capstone411/SHAF/README.md

# SHAF - Safe, Healthy, Active, and Flexible
All documents, code, presentations related to the SHAF team for capstone project at PSU (2015-2016)
