capstone411/SHAF/Capstone/bluetooth/Bluetooth_Specs.pptx

## Bluetooth Specs.

## Services

- Only 1 service is needed in the Bluetooth shield on the Arduino Board
- This service contains 3 characteristics
- UUID: 0x180D

## Characteristics

- 4 characteristics
  - Calibration flag
  - Rep Count
  - Fatigue Flag
  - Start/Stop Flag
- UUIDs
  - Calibration flag: 0x2a36
  - Rep Count: 0x2a37
  - Fatigue Flag: 0x2a38
  - Start/Stop Flag: 0x2a39
