capstone411/SHAF/Capstone/Presentations/semiFinalCornellCup.pptx

## SHAF (Safe, Healthy, Active and Flexible)

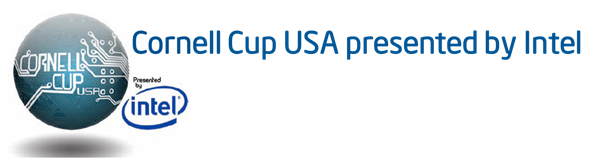
[picture p17: figure]

## Team Information

Students:

Ahmed Abdulkareem - Undergraduate Computer Engineer

Hai Dang Hoang - Undergraduate Computer Engineer

Todd Harlow - Undergraduate Computer Engineer

Thanh Tien Truong - Undergraduate Computer Engineer

Supervisor:

Mark Faust - Assistant Professor

## Topics

What is the challenge we want to focus on?

What is our solution to that challenge ?

How can we implement our solution ?

What work have we done so far ?

What are our next steps ?

## Challenge and Solution

45 million American adults have gym memberships in recent year

35 percent increase in workout-related injuries in recent years due to improper technique or inappropriate exercises

Many people don’t maximize the benefits of the exercises they perform because they don’t train the muscle intensely enough.

The ideal solution:
- Inexpensive and easy-to-use device
- Effective at providing correct methods for many exercises
- Accurate at alerting users to when they should stop

## Objective

To design and prototype a wearable device that can effectively support a user’s workout by allowing them to select their targeted muscle group and a corresponding exercise. Our device will provide users examples of the chosen exercise, count correct repetitions, and accurately alert them when they should stop the exercise. The device should be safe, easy to use, and portable.

## Current Existing Solutions and Our Solution

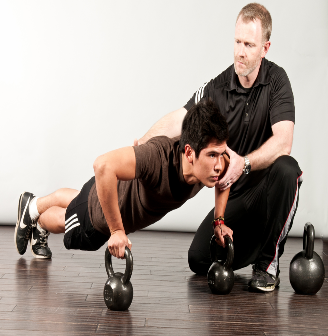
[picture p18: figure]
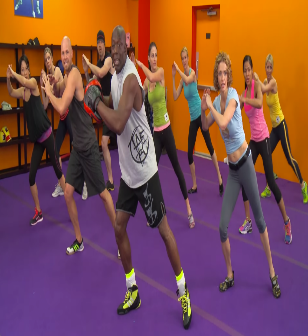
[picture p19: figure]

Workout Videos
3
3
2
5
5
18

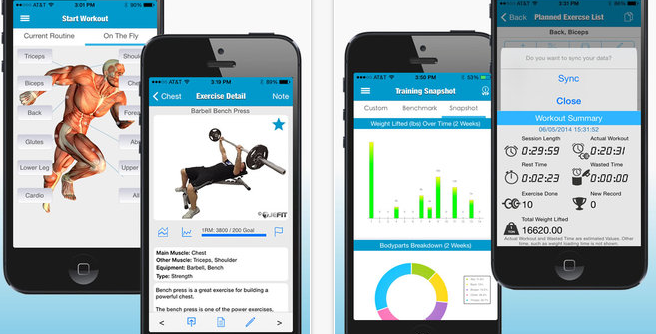
[picture p20: figure]

Videos Recording
5
3
2
4
3
17

| Personal Trainers
Cost | 1
Effectiveness | 5
Flexibility | 4
Ease of use | 5
Support all types of exercise | 5
Total | 20

Our Solution
4
4
5
5
3
21

A device that can:
  - Measure the intensity of muscle activity
  - Record the results
  - Correct your form
  - Detect muscle fatigue
  - Be used by anyone who wishes to improve their workouts and avoid injury

## Main Use Cases

Measure the intensity of a given muscle’s activity

Count the number of reps

Detect the muscle fatigue index

Provide video examples

Are my biceps “pumped”?

How many correct reps have I done so far?

When should I stop?

How can I perform an exercise correctly?

## Our Technical Solution

We use surface electromyography (sEMG) sensors to capture the voltage difference created by a contracting muscle

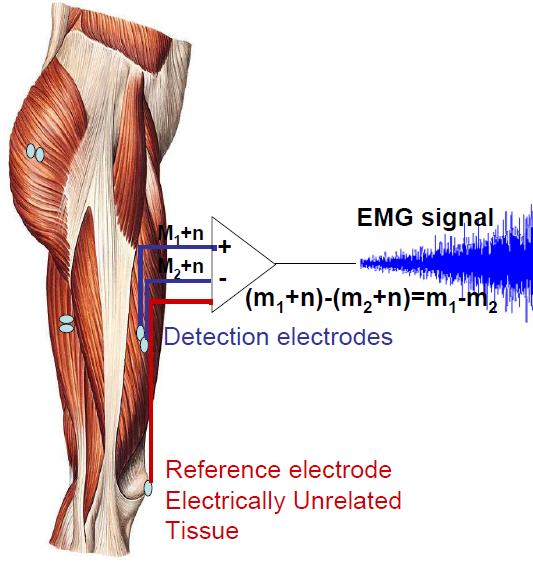
[picture p21: figure]

sEMG signals

We employ both simple and complex digital signal processing to extract key features

Time-domain processing
Frequency-domain processing

Is the muscle active ?
When is the muscle contracted / relaxed ?
How intense is the muscle activity?
Is the muscle fatigued?

## Our Physical Solution

A wearable sleeve working in conjunction with an Intel powered smart device

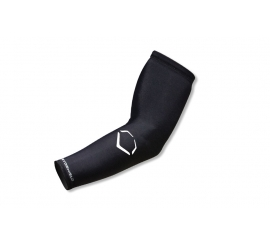
[picture p22: figure]
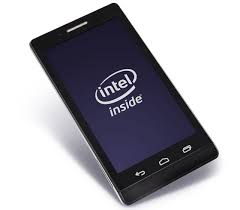
[picture p23: figure]
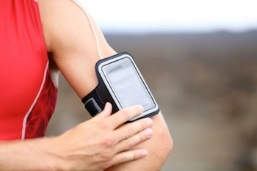
[picture p24: figure]

A wearable sleeve will measure sEMG signals and transmit data to a smart device

The smart device will let users choose the target muscle, the specific exercise for that muscle, and provide feedback

## Our Solution Summary

- sEMG sensors to record muscle data
  - Wearable garment containing custom-made sEMG electrodes and supporting circuitry.
  - Communicates via Bluetooth to smart device

- Intel Atom powered smart device to process data
  - Time-domain processing for muscle activation
  - Frequency-domain processing for muscle fatigue

- Device will also provide user interface
  - Audio and visual cues to keep user informed

## Flowchart for Our Solution

Time-domain analysis
Frequency-domain analysis

Intel Atom

Wearable sleeve with sEMG sensors

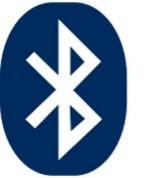
[picture p25: figure]

Is the muscle active?
When is the muscle contracted/relaxed?
How intense is the muscle activity?
Is the muscle fatigued?

User Interface

## Risks

What if the Intel Atom cannot handle all the signal and user interface processing?

What if our custom-made electrodes fail to provide an adequate signal?

Shift some or all signal processing
to an FPGA

We will use the off the shelf electrodes

## Our Current Achievements

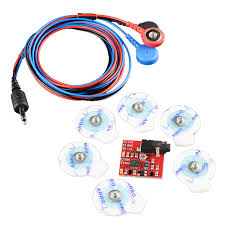
[picture p26: figure]

Muscle Sensor V3 (sEMG sensor)

Successfully detected when muscle is contracted or relaxed and can count repetitions

Making progress on detecting muscle fatigue

Completed a concept for user interface

## Muscle is contracted/relaxed

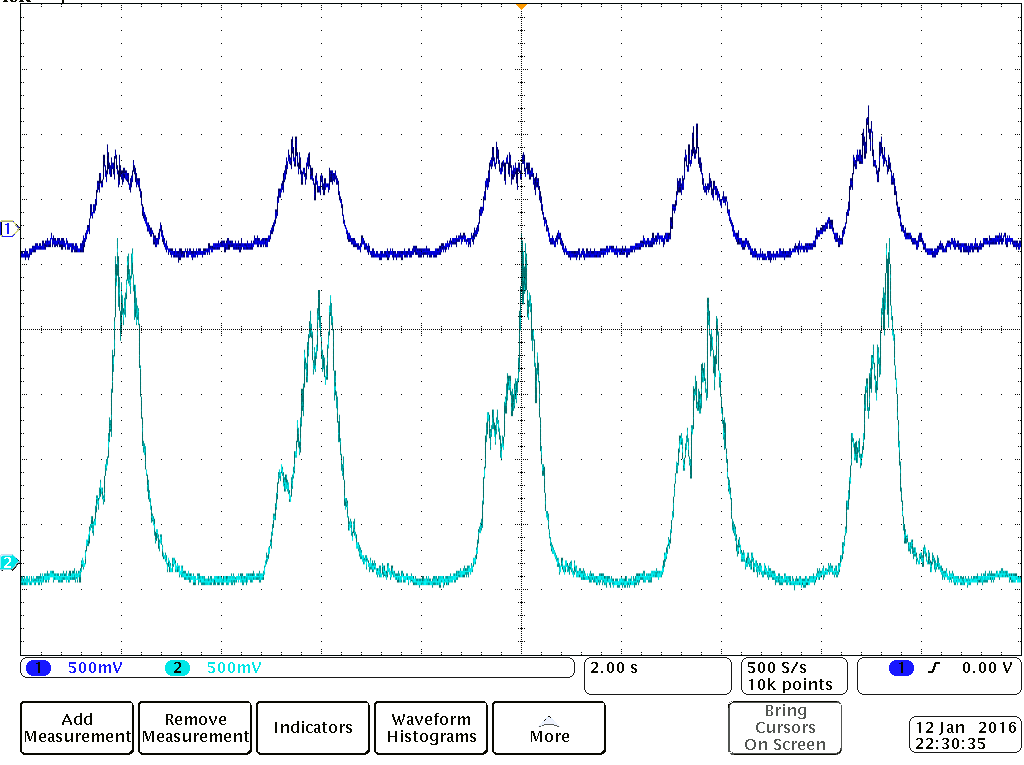
[picture p27: figure]

Doing multiple curls (sEMG signal for bicep and tricep)

tricep

bicep

## Muscle is contracted/relaxed

sEMG signal from the sensor

ADC

Not in range

Within acceptable range of upper bound threshold?

in range (contracted)

Within acceptable range of lower bound threshold?

in range (relaxed)

Increment rep

ADC

Not in range

## Demo Video

https://www.youtube.com/watch?v=X1IopbZivjs&fea

## Detecting Muscle Fatigue

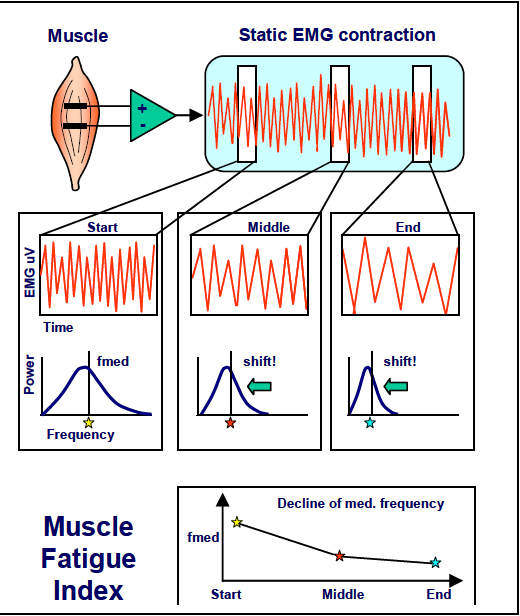
[picture p28: figure]

Konrad, P. (2006). The ABC of EMG – A Practical Introduction to Kinesiological Electromyography. Noraxon U.S.A. Inc

Key idea:
Mean or median frequency will decrease when muscle is fatigued

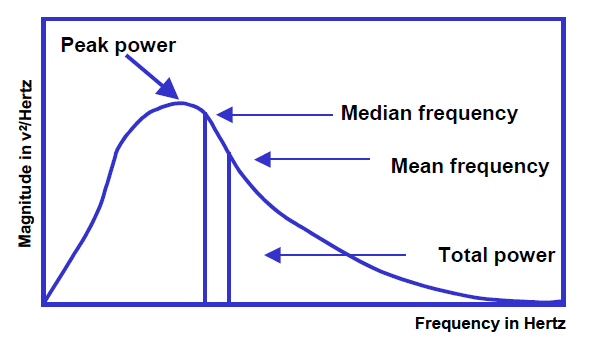
[picture p29: figure]

## Detecting Muscle Fatigue

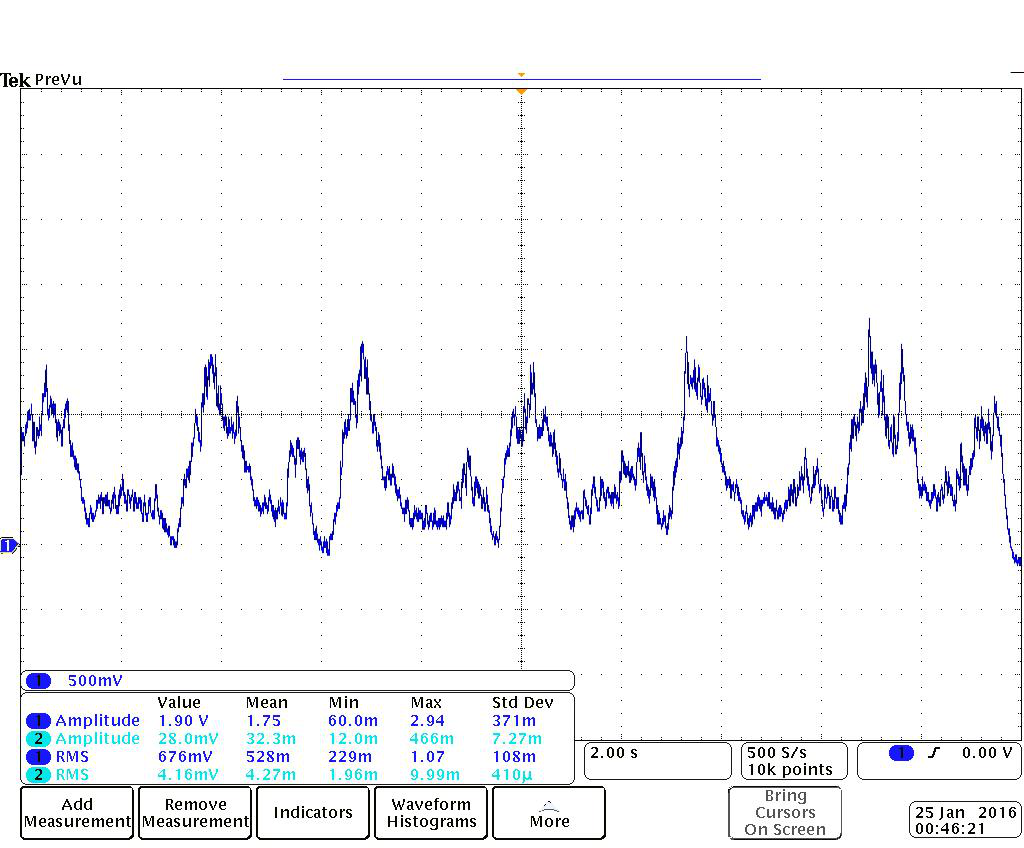
[picture p30: figure]

Bicep signal, normal curls

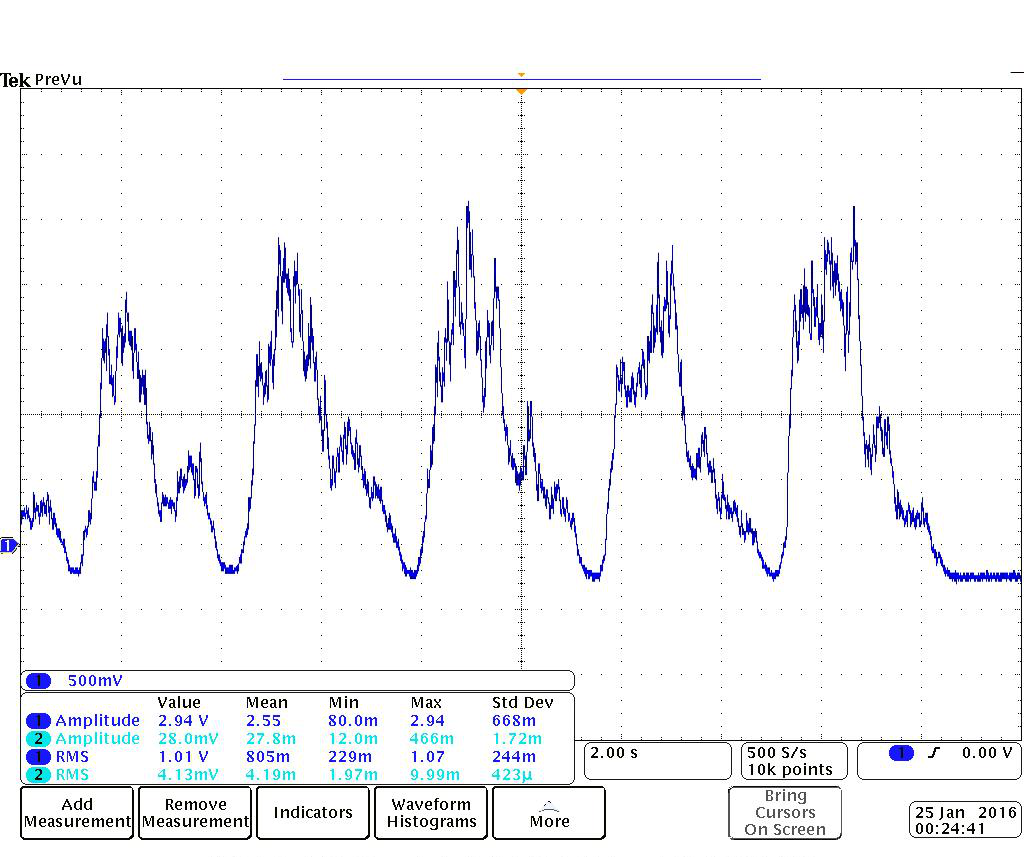
[picture p31: figure]

Bicep signal, fatigued curls

## Detecting Muscle Fatigue

sEMG signal from the sensor

Apply FFT

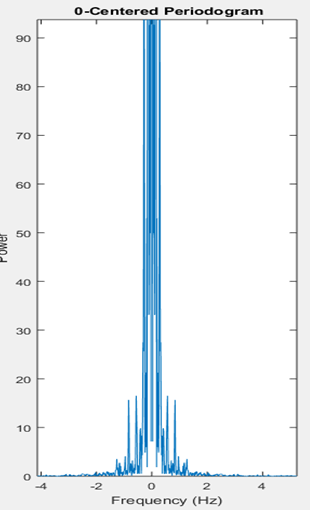
[picture p32: figure]

Compute mean or median power frequency

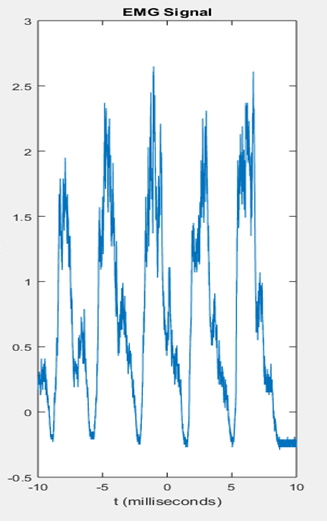
[picture p33: figure]
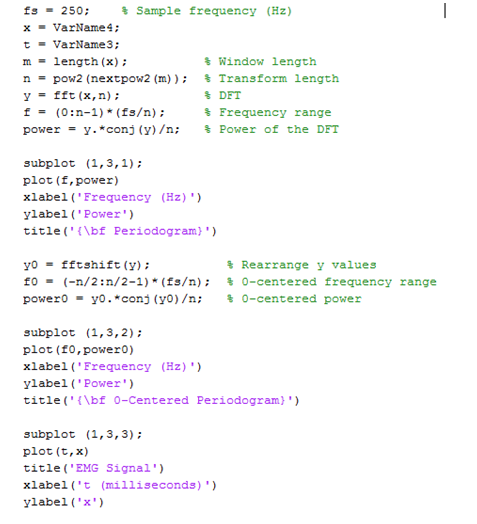
[picture p34: figure]

Do the comparison

Our mean and median power frequency increases

Different from our expectation

## User Interface

Select target muscle

Select exercise

Dumbbell Bicep Curl

Barbell Curl

Drag Curl

Watch the example video

Perform the exercise and observe the results

Human body graphic shows which muscle is active

Alert user when the target muscle is fatigued

Bicep

Each exercise will have it own video

Body-Up

Cobra Triceps Extension

Tricep

## Where are we currently at ?

Obtain information and ideas

Define requirements and create specifications

Get samples and do signal analysis

Get needed equipment

Test the device

Deliver

Create GUI and work on Bluetooth communication

Create a wearable garment

## How much we have spent so far ?

Equipment | Cost per unit | Quantity | Total
Muscle Sensor V3 | $50 | 3 | $150
Arduino Uno Board | $20 | 2 | $40
Electrical Components kit | $40 | 1 | $40
Wearable Garment | $82 | 1 | $82
Total | $312

## Next Steps

- Create a GUI for the device

- Learn Bluetooth communication using the Intel Atom

New resource required:

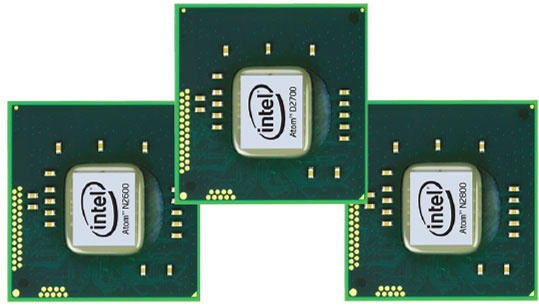
[picture p35: figure]

Intel Atom

- Develop an effective method to detect muscle fatigue index accurately

- Create a wearable garment

- Combine all the parts to create the prototype

- Test the prototype

## Schedule and Additional Cost

Task | Time
Create GUI | Mid February - April
Learn Bluetooth communication | 1 month after we receive the Atom board
Develop method to detect muscle fatigue | Mid February - March
Create wearable garment | Mid February - March
Create working prototype | March – Mid April
Testing | Mid April - May

Additional Equipment | Cost per Unit | Quantity | Total
Electrodes | $6 | 10 | $60
Total | $60

## Summary

Budget

Have been used:
- $312

Device Information

Purpose:
- Improve individual workout quality

Functionality:
- Use sEMG signal
  - to measure muscle activity
  - to detect muscle fatigue
- Provide user interface
  - to provide workout videos
  - to record workout results

Time expectation

Device is ready for testing:
- Mid April

Device is ready for delivery:
- Early May

Additional Cost:
- $60

## Thank you for listening
