capstone411/SHAF/Capstone/Presentations/Project_Enhancement.pptx

## Enhancing the Capstone Project

- Hardware-based?
  - We believe the team does not have enough time to research, implement, and integrate any new feature to the project that would require additional hardware, e.g. additional electrodes, accelerometer, etc.
- Software-based?
  - An achievable enhancement to the project is one that can be implemented programmatically using the sEMG voltage data already available.

## Possible Software-Based Enhancements

- Add a “rep rate” calculator
  - Stupid simple calculation (reps/time)
- Predict 1-rep max weight
  - Simple calculation, would require one additional input from user (weight or resistance used for reps)
  - Could be extrapolated to N-rep weight calculation
- Add support for isometric exercise
  - Would require additional data collection (bulk of current data is reps, not isometric contraction)
  - Could possibly combine rep results and isometric results for an overall evaluation of muscle performance
- Link voltage to pitch of a generated sound
  - User could hear their muscles working, could possibly improve repetition repeatability
  - Fun! (Although potentially annoying to other gym users!)
