capstone411/SHAF/Capstone/Presentations/App_prototype.pptx

## GUI Design

iPhone

## First Screen (Connection Establishment)

Connect

Background

## Selecting the device

Select Device:

## Establishing a Connection

Background

connecting/connected

## Select Your Goal

Select Goal:

Power

Endurance

Strength

## Select Muscle

Select Muscle:

Biceps

## Select Exercise

Select Exercise:

Barbell Curls

Dumbbell Curls

Hammer Curls

Cable Curls

## Demo Video

Demo Video

Skip

## Calibration

## Initiating

Start

## Real Time Results

Number of correct reps: X

Done

Power

Fatigue

Fatigue

## Real Time Results

Number of correct reps: X

Done

Power

Fatigue

Fatigue

## What to do Next?

What would you like to do?

New Exercise

New Goal

Re-watch Demo

Quit
