capstone411/SHAF/Capstone/Presentations/sEMG Signal Analysis.pptx

## sEMG Signal Analysis

1. Test signal

2. New Algorithm

3. Experiment (Raw and envelope signal)
  - Curl
  - Isometric

4. Professor James McNames’s advice

## Test Signal

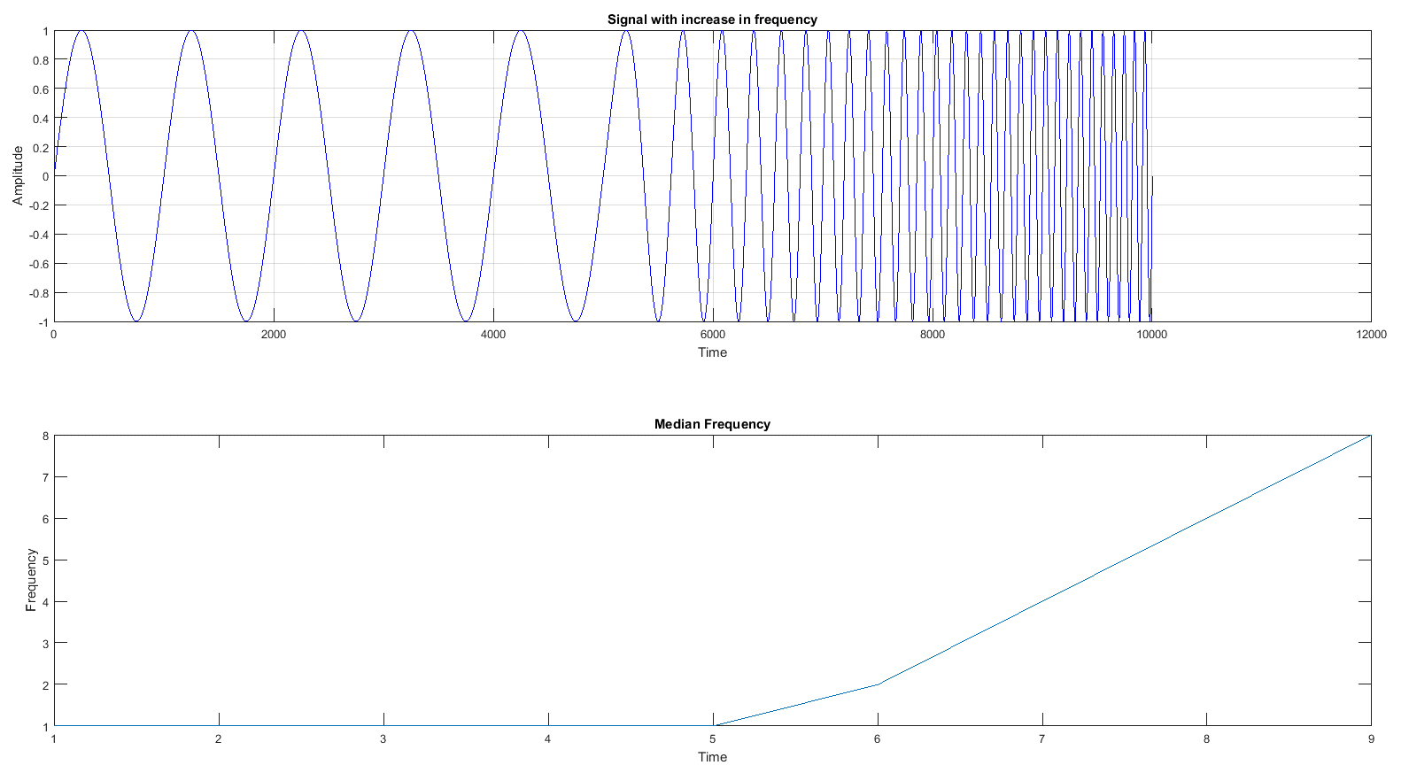
[picture p36: figure]

Test Signal

Result after using MATLAB code to compute the median frequency

## New Algorithm

Motivation: Median frequency in MATLAB (medfreq(x,n)) is not a correct way to compute “Median Power Frequency”

Raw EMG

Import all the data into MATLAB

Envelope EMG

Shift to zero base line to rectify all the data

Perform integration to compute the area under the curve

Find the frequency that split the area in half

Split the data into consecutive windows

Apply FFT for each window

## Raw Signal (Curls)

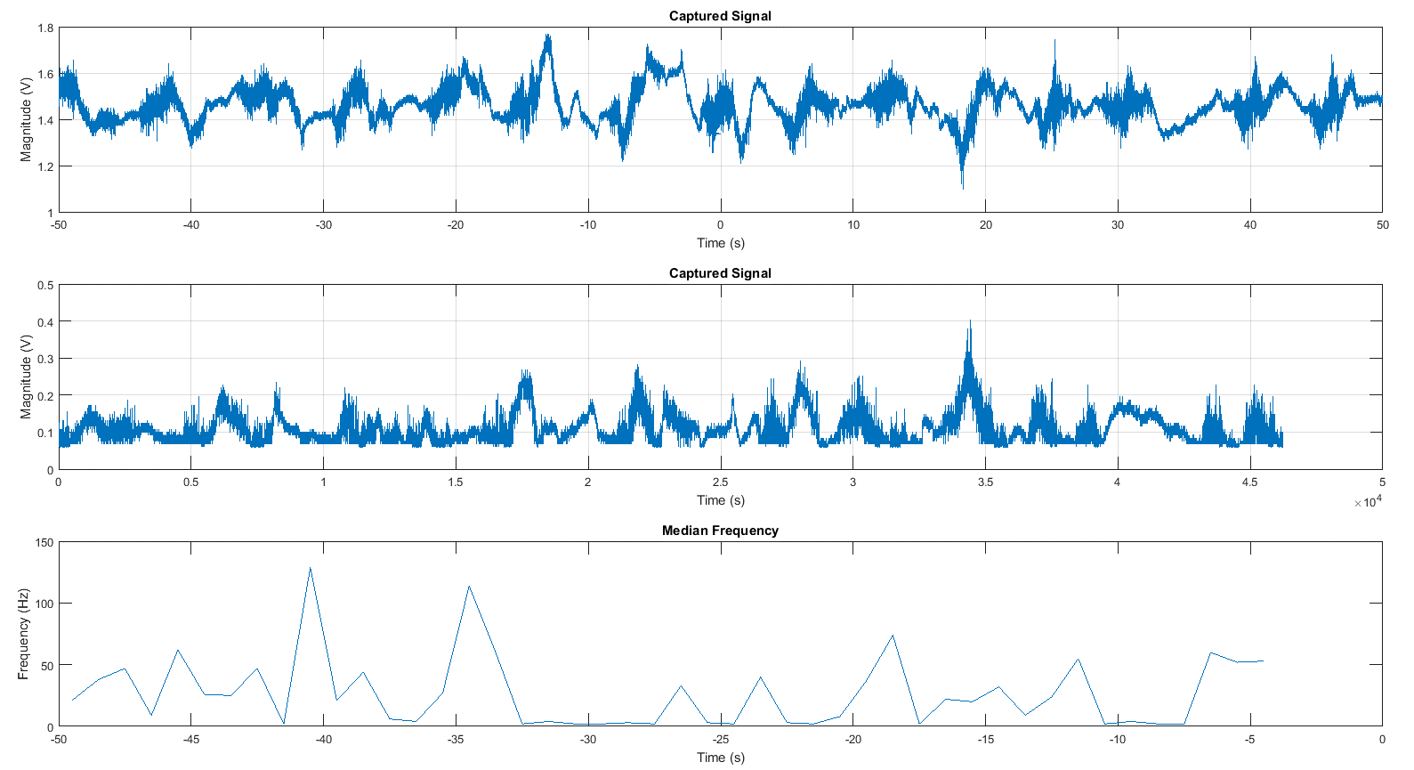
[picture p37: figure]

Used raw signal
Performed 15 curls, felt fatigued on curl 12
Oscilloscope sample rate: 1kHz

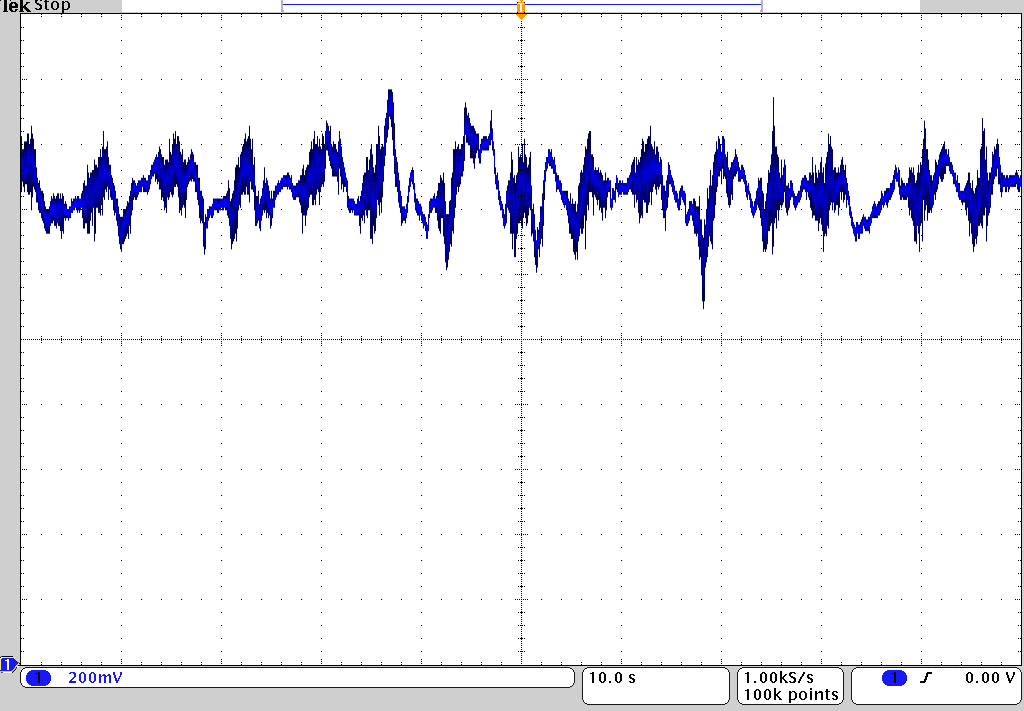
[picture p38: figure]

Raw EMG signal of the last 12 curls

Results from MATLAB

## Slide 5

Envelope Signal (Curls)

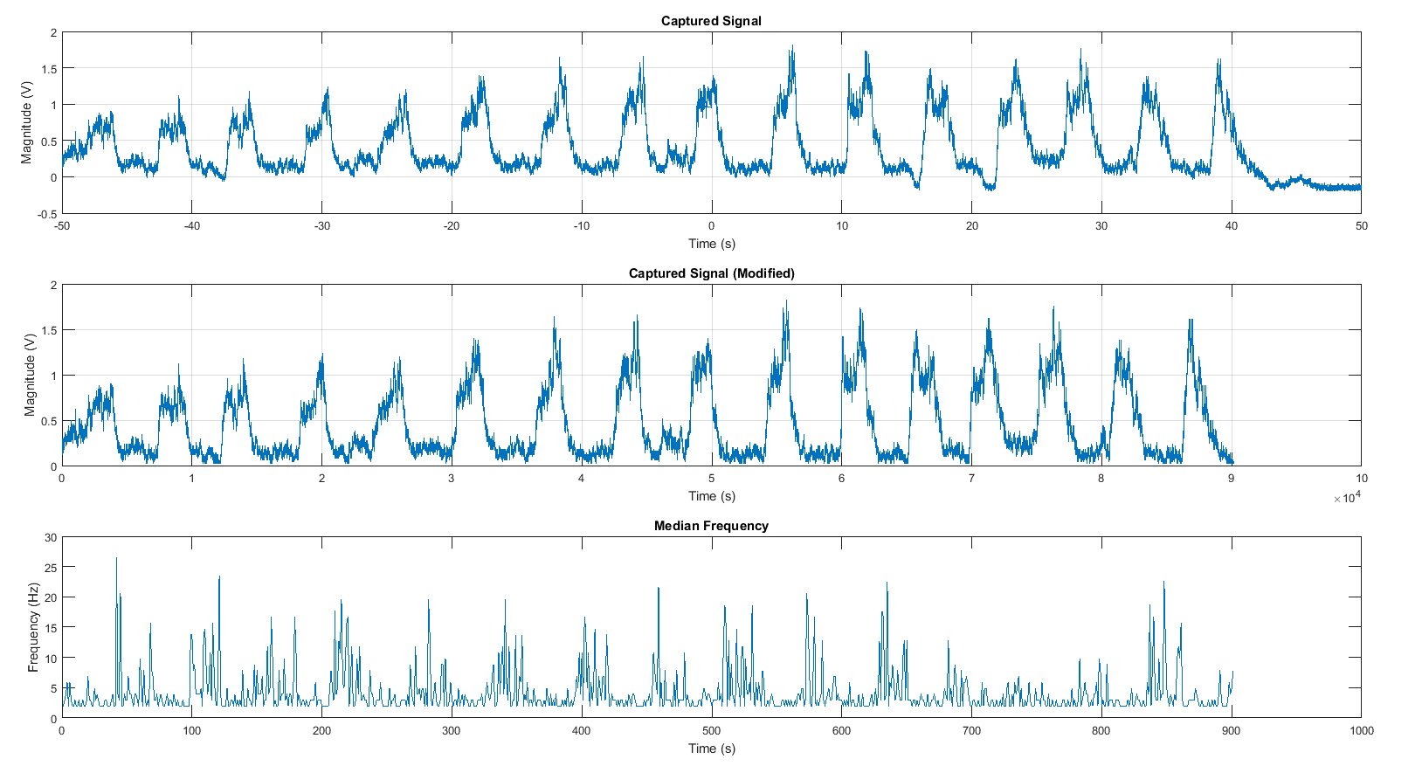
[picture p39: figure]

Results from MATLAB

Used envelope signal
Performed 20 curls, felt fatigued on curl 16
Oscilloscope sample rate: 1 kHz

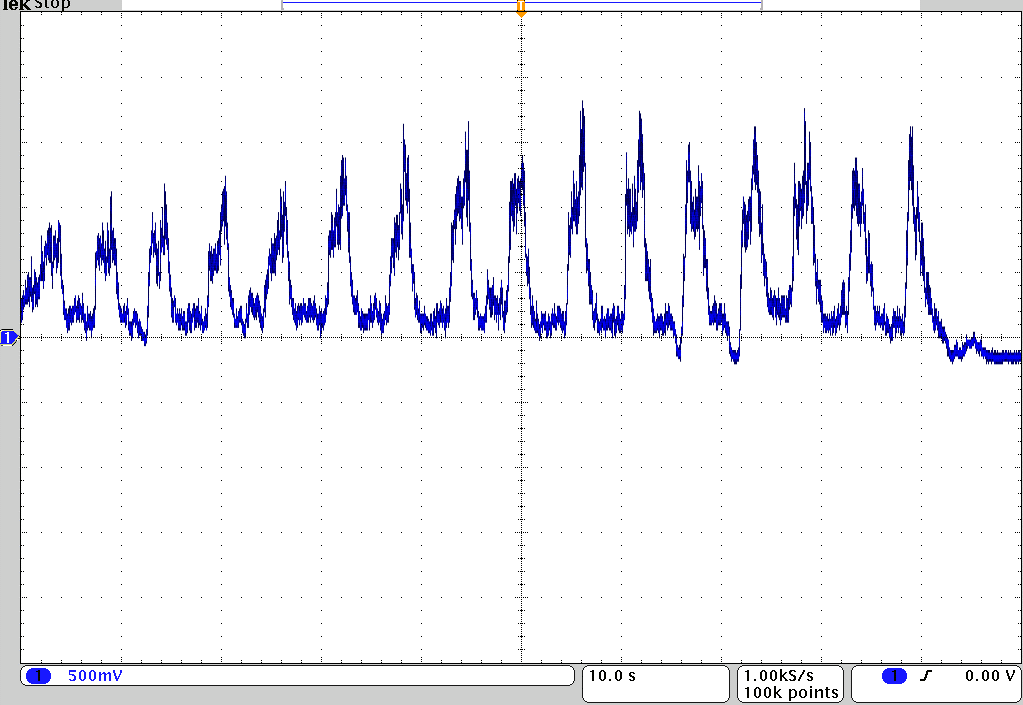
[picture p40: figure]

Envelope EMG signal of the last 16 curls

## Slide 6

Raw Signal (Isometric)

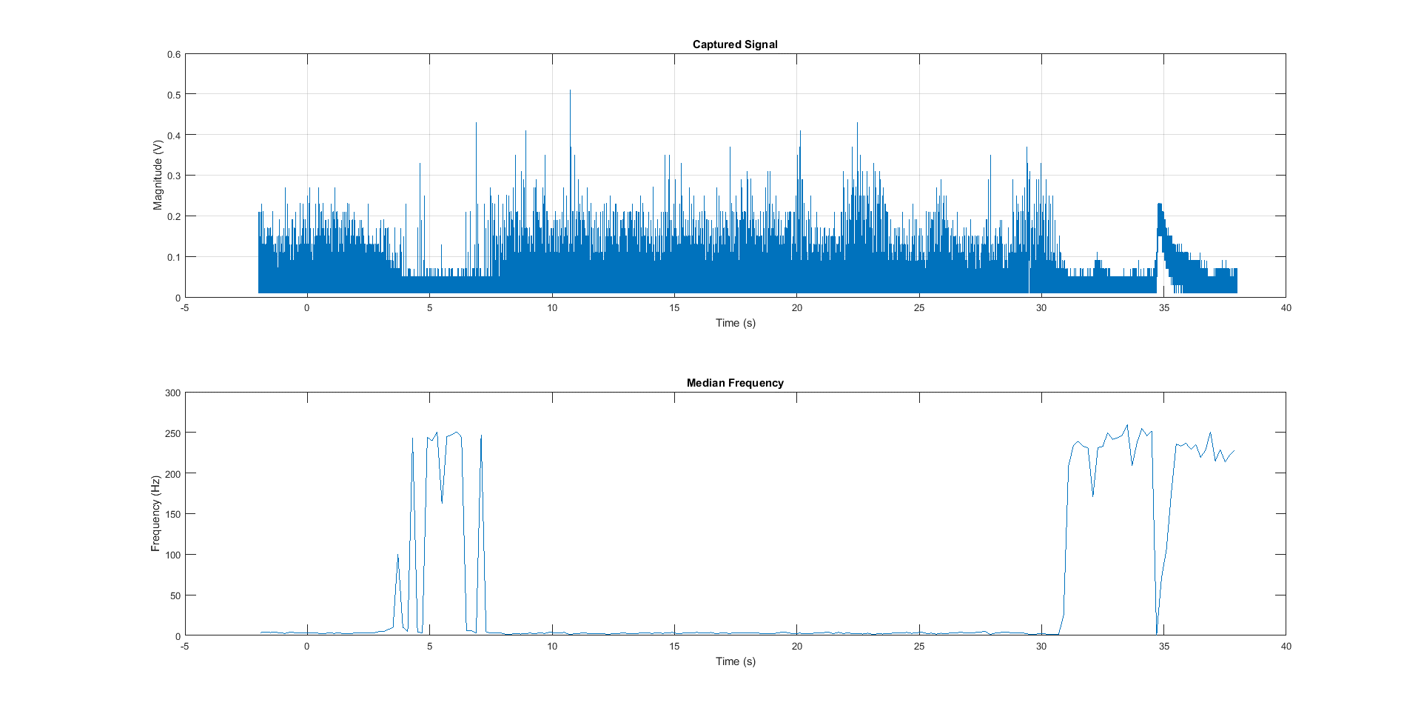
[picture p41: figure]

Used raw signal
Held an object for 40s, felt fatigued for last 10s
Sample rate is 1k Hz (Oscilloscope)

## Slide 7

Envelope Signal (Isometric)

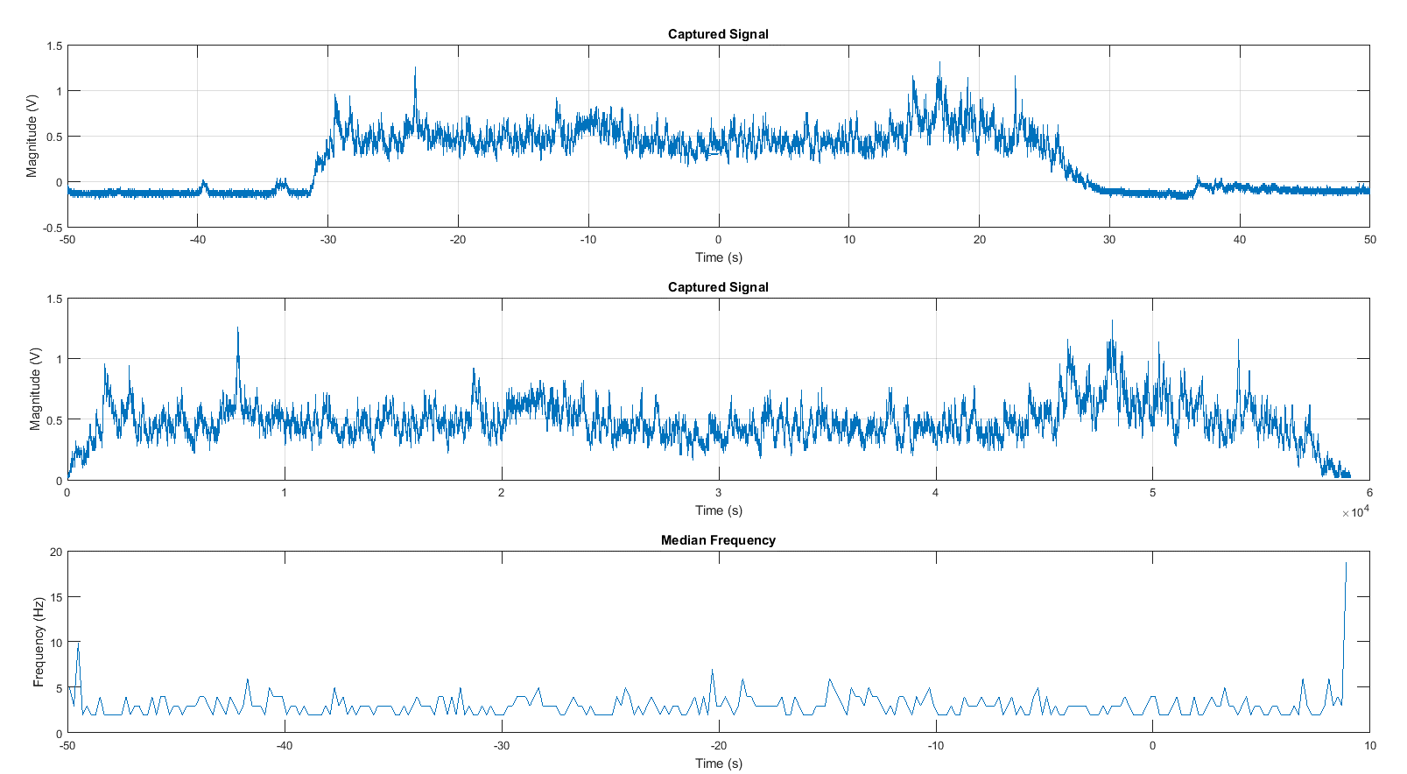
[picture p42: figure]

Results from MATLAB

Used envelope signal
Held an object for 40s, felt fatigued for last 10s
Oscilloscope sample rate: 1 kHz

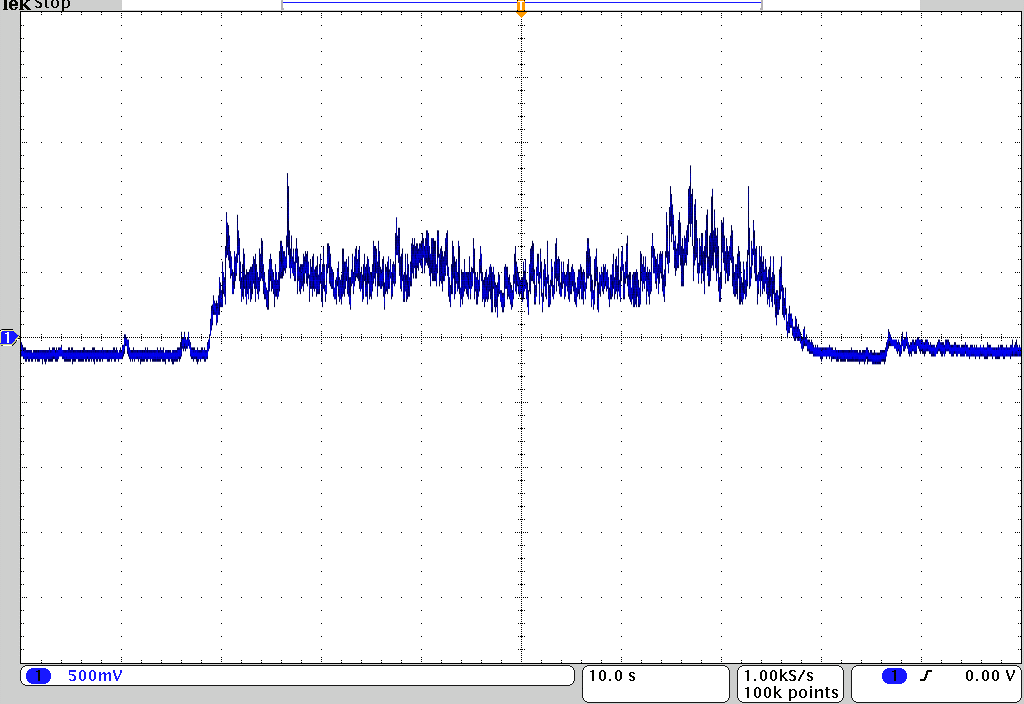
[picture p43: figure]

Envelope EMG signal

## Professor James McNames’s Advice

Median power frequency is not a good indicator for muscle fatigue, especially with non-isometric exercise.

Median power frequency is very sensitive to:
- The location of the electrodes on the skin
- The skin condition (wet, dry, hairy)

Recommended alternative way:
- Using heart beat rate and breath rate to indicate muscle fatigue

Get advice from an expert:
- Professor Gary Brodowicz, the director of the exercise physiology laboratory and director of the university's fitness assessment service-ON TRAC

## Discussed Alternatives for Detecting Fatigue

- Heart rate
  - Suggested by Prof. McNames
  - Would required an additional sensor
- Don’t use signal properties
  - Instead, recommend an amount of reps
  - Update recommendation using actual user rep count
- Increasing amplitude (time domain)
  - Detect increasing amplitude on fatigued repetitions
  - Mentioned in literature
  - Can be seen on envelope signal graph of curl exercise
- We meet with Dr. Brodowicz on 2/25 at 11 AM
