capstone411/SHAF/Capstone/IOS_app/screenShots/IMG_1094.PNG

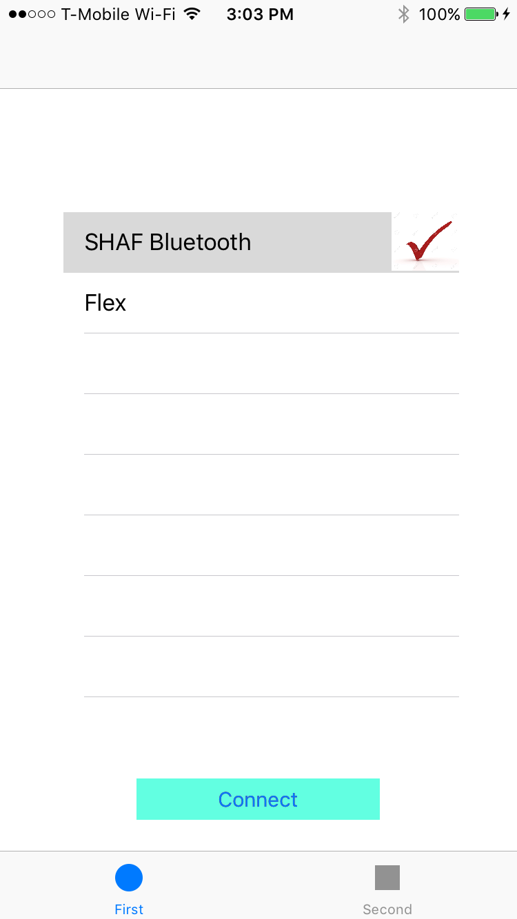
Capstone/IOS_app/screenShots/IMG_1094.PNG
