capstone411/SHAF/Capstone/IOS_app/screenShots/IMG_1095.PNG

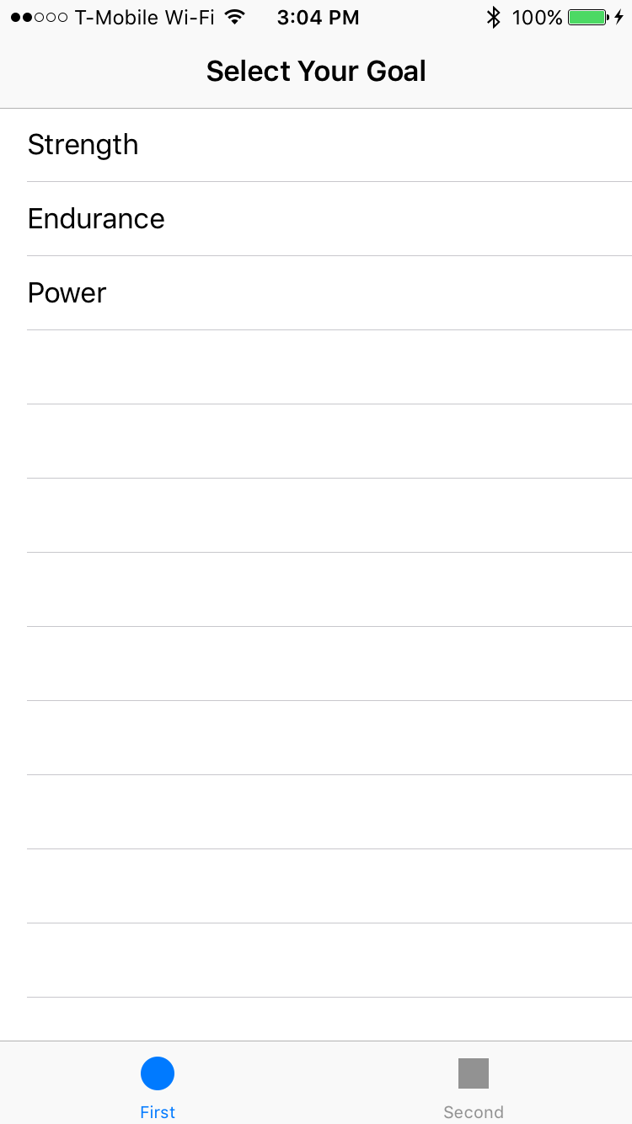
Capstone/IOS_app/screenShots/IMG_1095.PNG
