capstone411/SHAF/Capstone/IOS_app/screenShots/IMG_1101.PNG

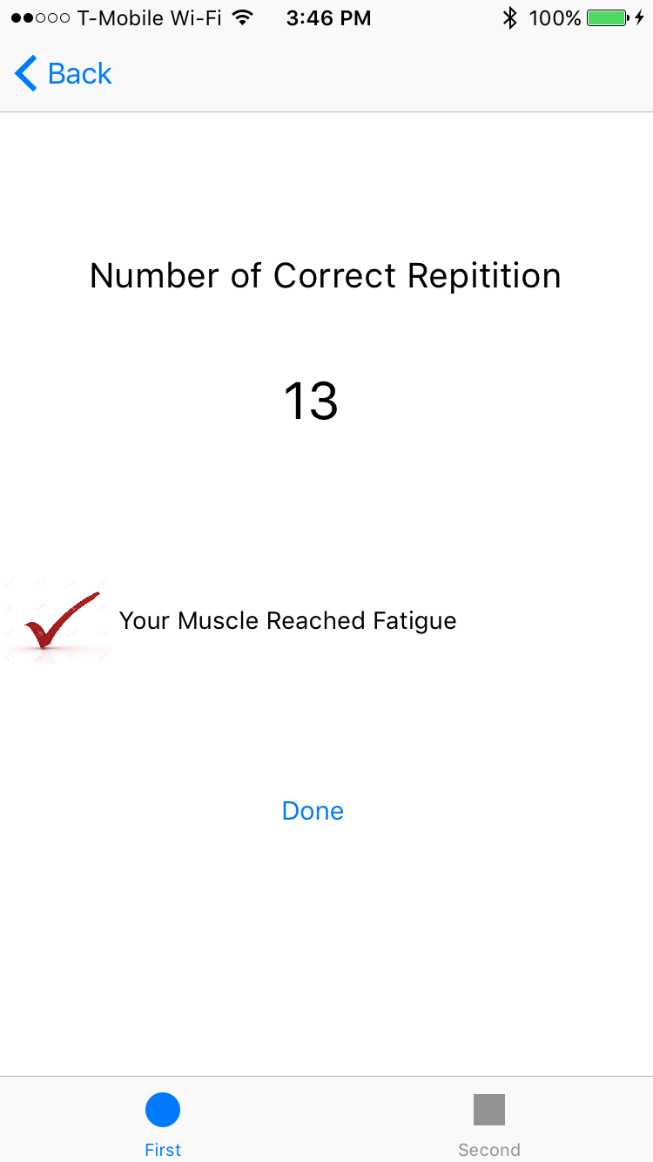
Capstone/IOS_app/screenShots/IMG_1101.PNG
