capstone411/SHAF/Capstone/Presentations/Apple-iPhone-6-Plus-with-iOS8-Pixelmator-Template-Blog-Post.png

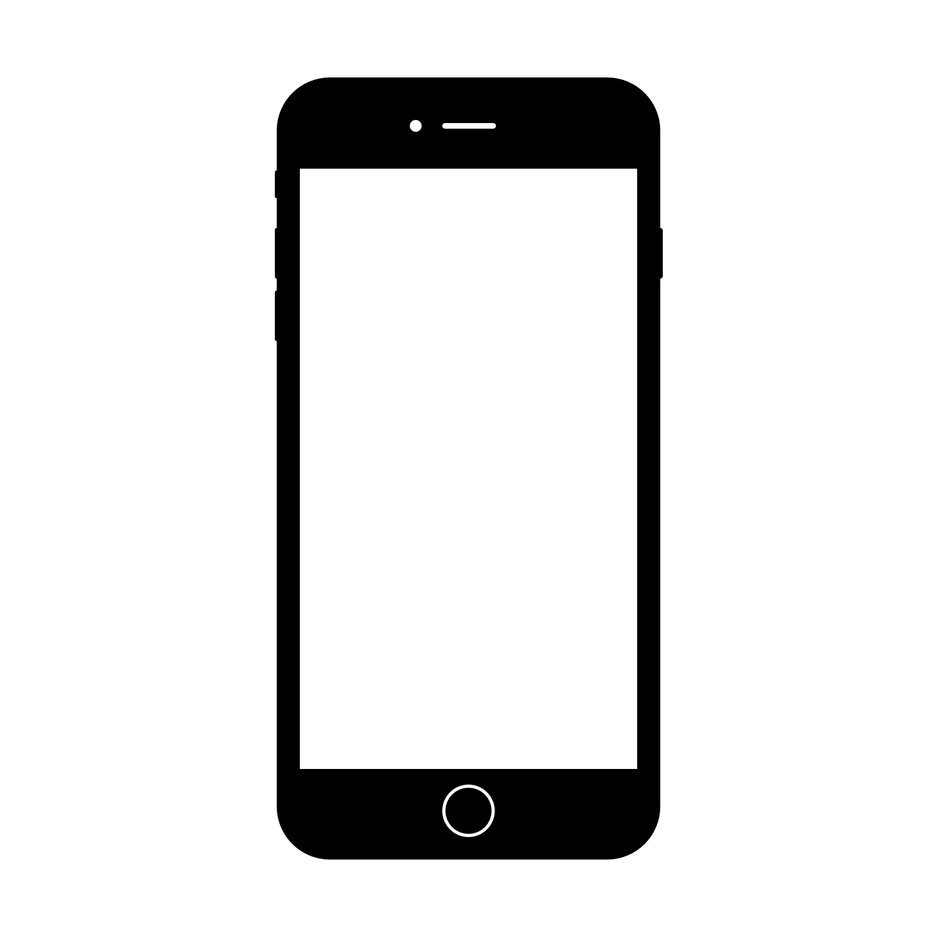
Capstone/Presentations/Apple-iPhone-6-Plus-with-iOS8-Pixelmator-Template-Blog-Post.png
