capstone411/SHAF/Capstone/Presentations/btCommUML.pdf

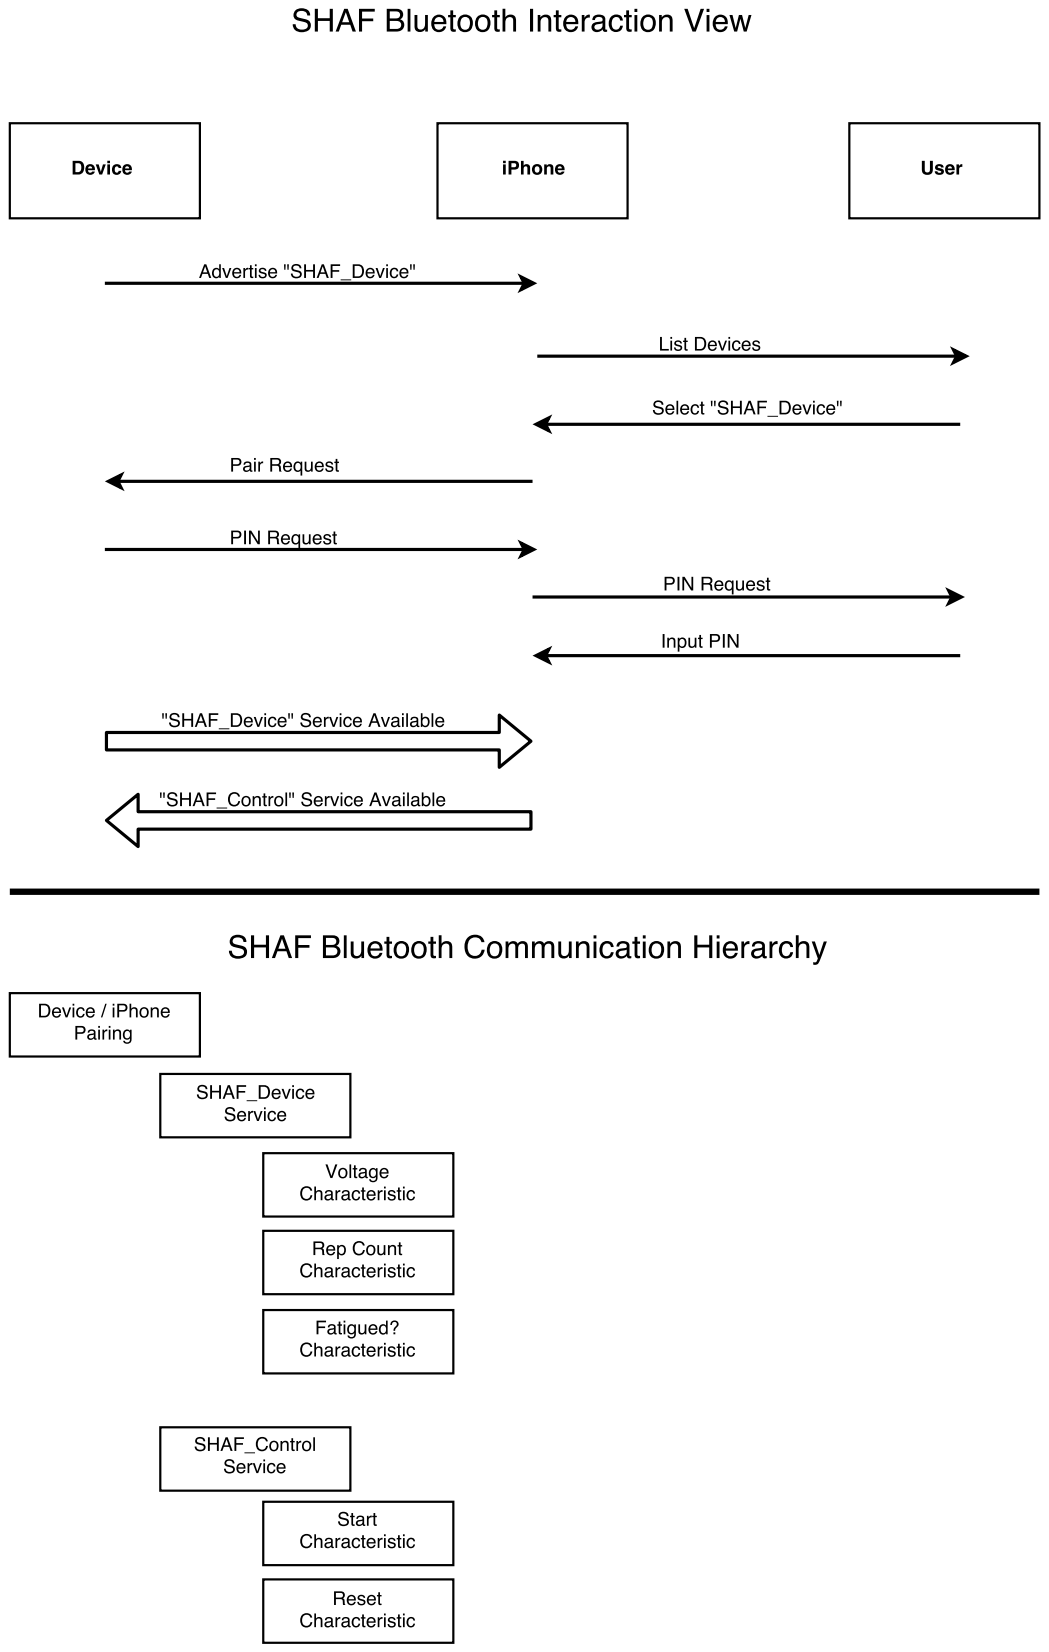
[picture p52: page 1]
