capstone411/SHAF/(commit log)

2016-02-05 grading for semi-final
    [IntelCornellCup_SemiFinalsCriteria_8_2014_aa.xlsx]
2016-02-13 Added fitbit flex slide, revised beast sensor slides, and corrected metrics numbers
2016-02-17 Edited use-case
    Changed wording in use-case to reflect device's ability to detect
    fatigue
2016-02-24 BLE Power Point
2016-02-24 Presentations for Feb. 24 Meeting
    - Updated Project doc
    - Added to Bluetooth slide
    - Edited and added to “sEMG Signal Analysis” slide
    - Added new project schedule
2016-03-02 app prototype presentation - needs work for the calibration slide
2016-04-19 new features: - I'm ready slide - bigger rep count label - fatigue only appears when signaled - check mark appears next to SHAF device to indicate that's the one to connect to - activity indicator vi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
2016-04-20 Add WPR amd MATLAB algorithm
    [bicep_isometric_7k_samples.csv, junk_data_delete_me.csv]
2016-04-22 Revise test plan and add form
    [form.xlsx]
2016-05-03 Add MATLAB work
    [junk_data_delete_me.csv]
2016-05-05 Data and algorithm stuff
    [observedReps.csv]
2016-05-10 Add MATLAB stuff
    [baseline.csv, s99_L1_detectedReps.csv, s99_L2_detectedReps.csv, s99_R1_detectedReps.csv, s99_R2_detectedReps.csv, threshold.csv]
2016-05-17 add matlab and results data
    [s10_l1_repCounts.csv, s10_l2_repCounts.csv, s10_r1_repCounts.csv, s10_r2_repCounts.csv, s11_l1_repCounts.csv, s11_l2_repCounts.csv, s11_r1_repCounts.csv, s11_r2_repCounts.csv]
2016-05-19 Add data, reports, WPR
    [fatigueRepReport.csv, fatigueRepReport.xlsx, repDiffReport.csv, repDiffReport.xlsx, s10_l1_fatigueReps.csv, s10_l2_fatigueReps.csv, s10_r1_fatigueReps.csv, s10_r2_fatigueReps.csv]
2016-05-26 Add matlab results and poster
    [repDiffReport.xlsx, repDiffReport2.csv, repDiffReport3.csv, s16_l1_fatigueReps.csv, s16_l1_repCounts.csv, s16_l2_fatigueReps.csv, s16_l2_repCounts.csv, s16_r1_fatigueReps.csv]
2016-05-26 Add updated fatigueRepReport and MATLAB ppt
    [fatigueRepReport.xlsx, fatigueRepReport2.csv, repDiffReport.xlsx]
2016-06-02 Added code for checking if device disconnects
2016-06-02 Create Arduino Code
2016-06-02 Revise final presentation, add code, comment more MATLAB files
    [bicep_isometric_7k_samples.csv]
